jerry-fan07/windshield-ARHUD/docs/arhud-road/shots/chase-view.jpg

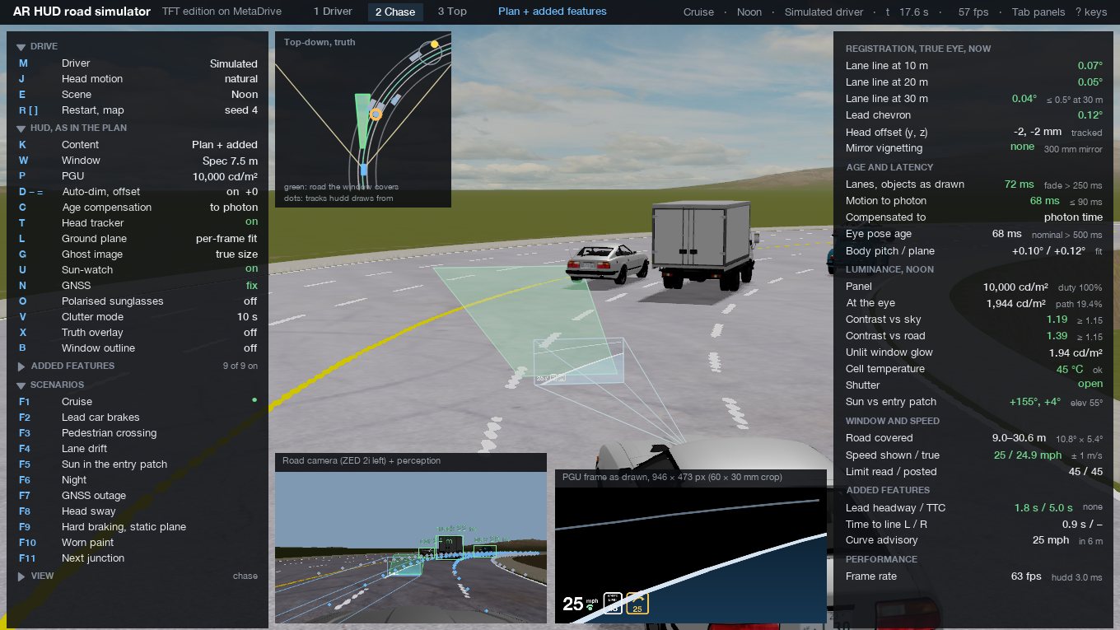
docs/arhud-road/shots/chase-view.jpg
