jerry-fan07/windshield-ARHUD/docs/arhud-road/shots/driver-hud-zoom.jpg

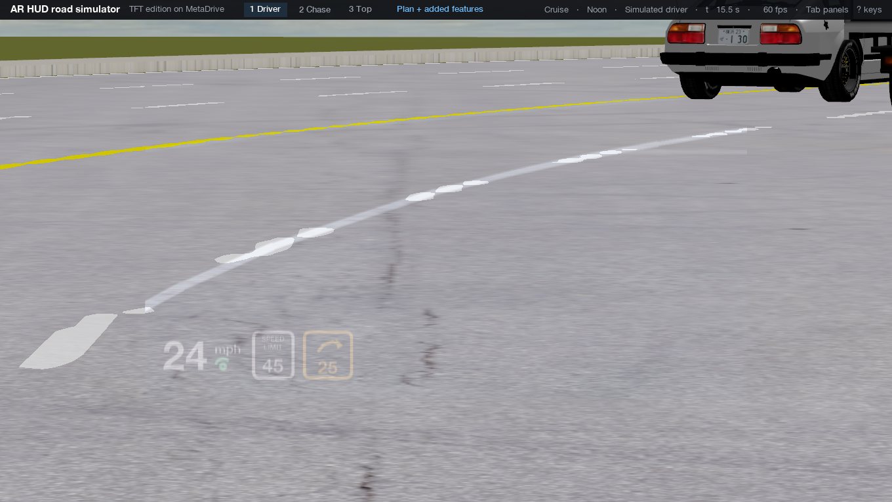
docs/arhud-road/shots/driver-hud-zoom.jpg
