jerry-fan07/windshield-ARHUD/docs/arhud-road/shots/lane-drift.jpg

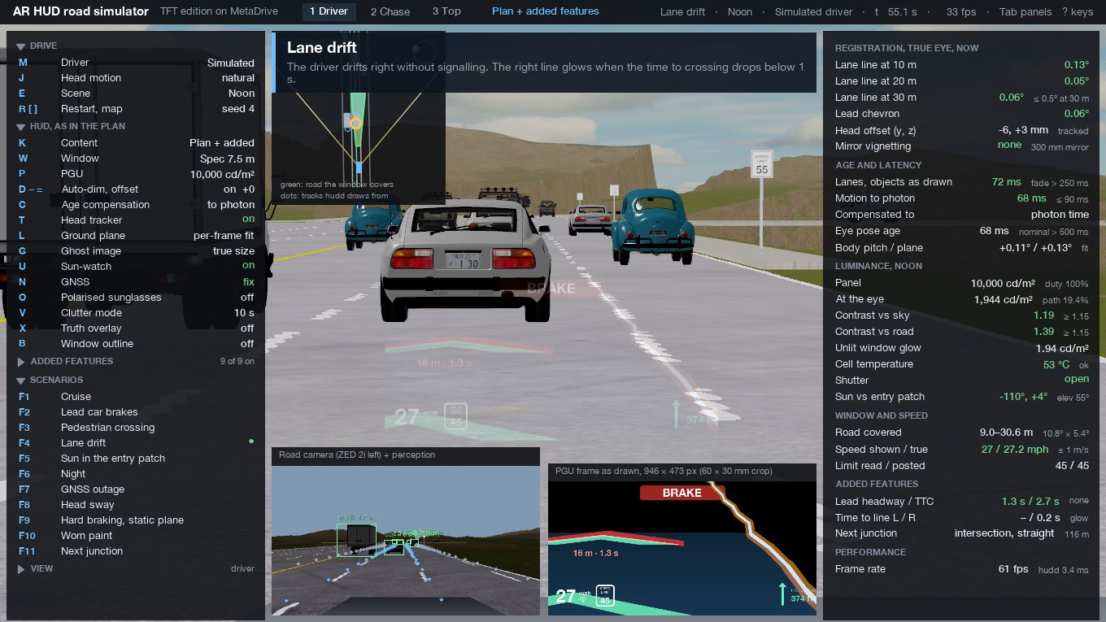
docs/arhud-road/shots/lane-drift.jpg
