jerry-fan07/windshield-ARHUD/docs/arhud-road/shots/lead-brake-fcw.jpg

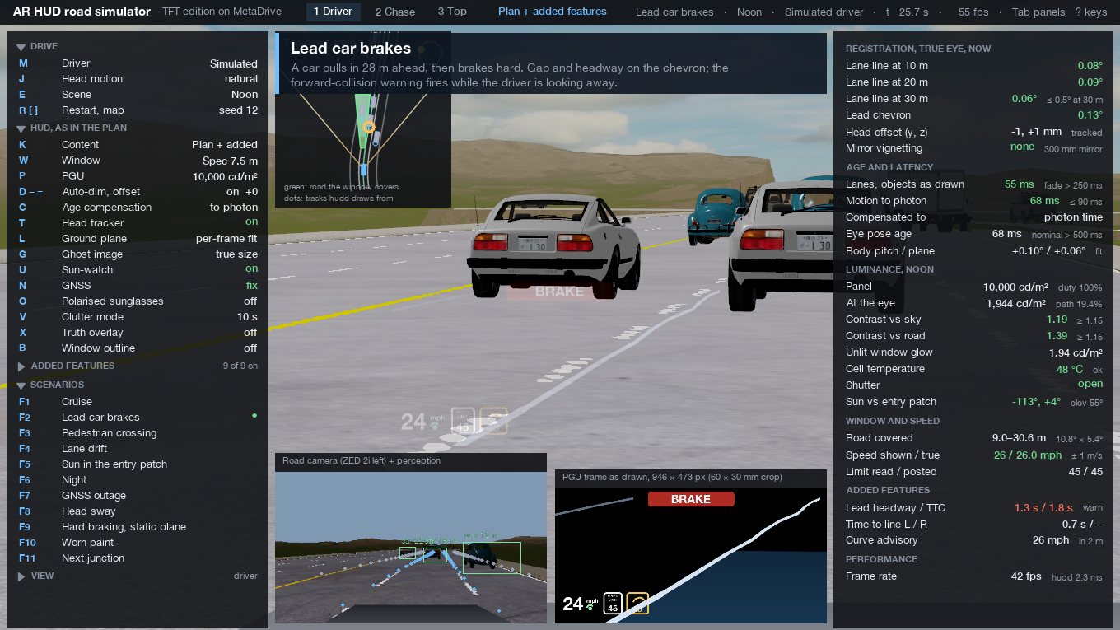
docs/arhud-road/shots/lead-brake-fcw.jpg
