jerry-fan07/windshield-ARHUD/docs/arhud-road/shots/night.jpg

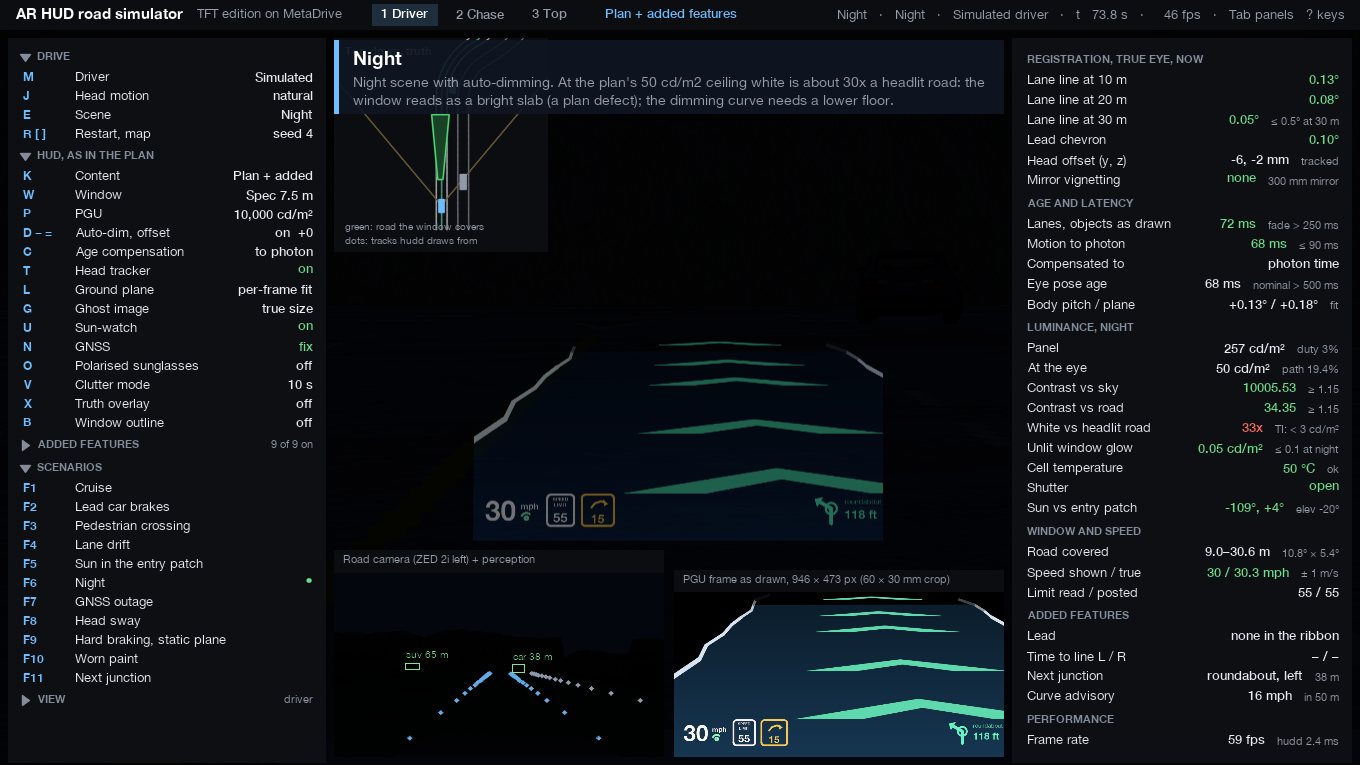
docs/arhud-road/shots/night.jpg
