jerry-fan07/windshield-ARHUD/docs/arhud-road/shots/pedestrian-crossing.jpg

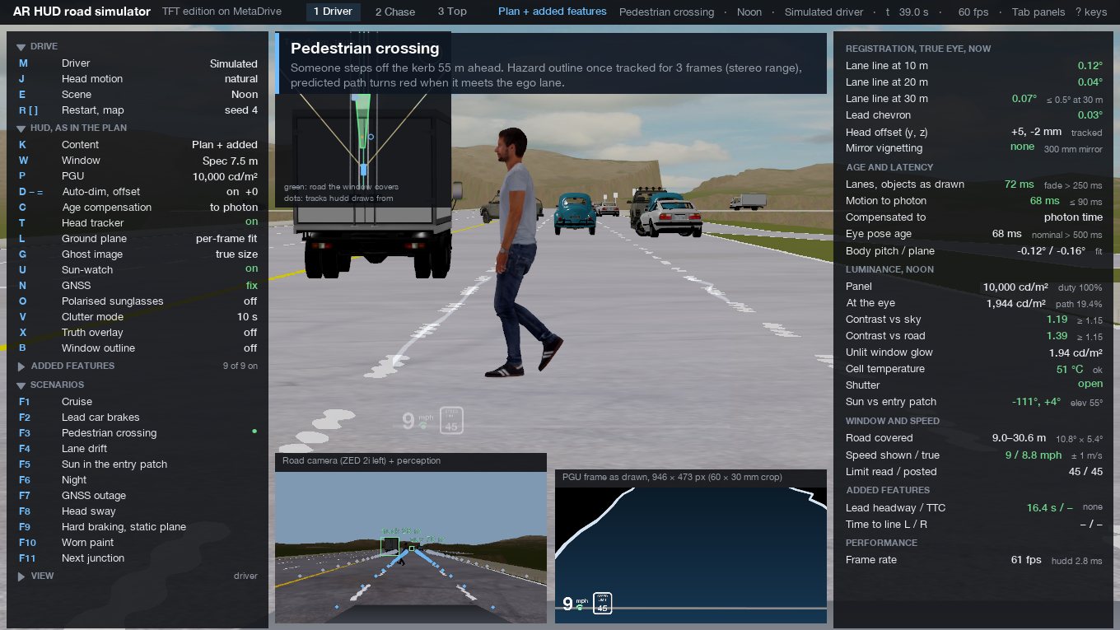
docs/arhud-road/shots/pedestrian-crossing.jpg
