jerry-fan07/windshield-ARHUD/docs/arhud-road/shots/plan-as-written.jpg

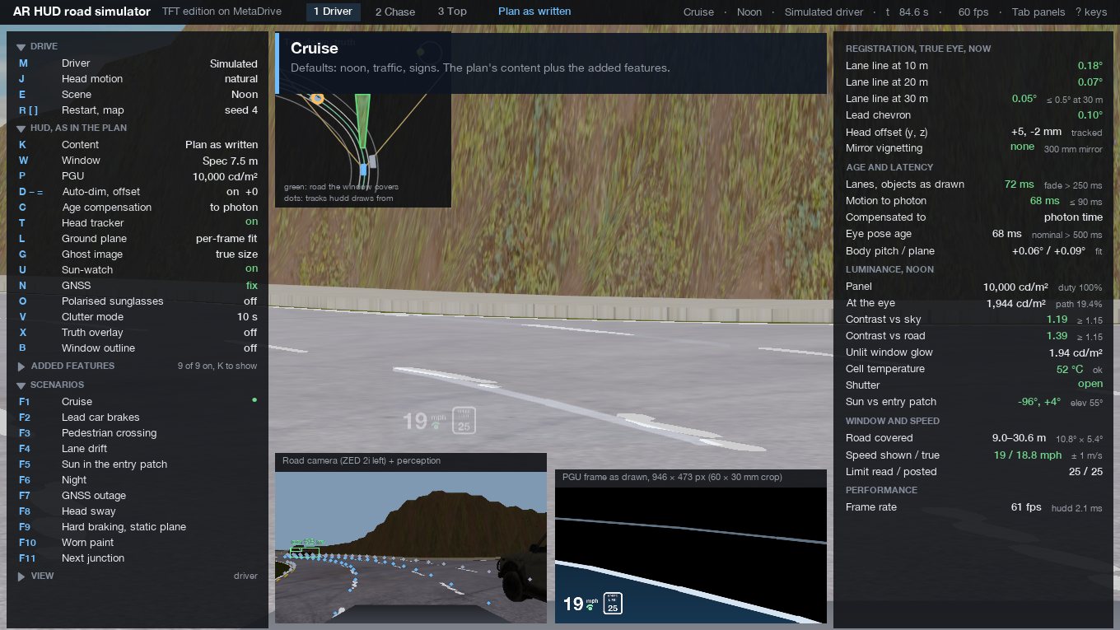
docs/arhud-road/shots/plan-as-written.jpg
