jerry-fan07/windshield-ARHUD/docs/arhud-road/shots/sun-in-patch.jpg

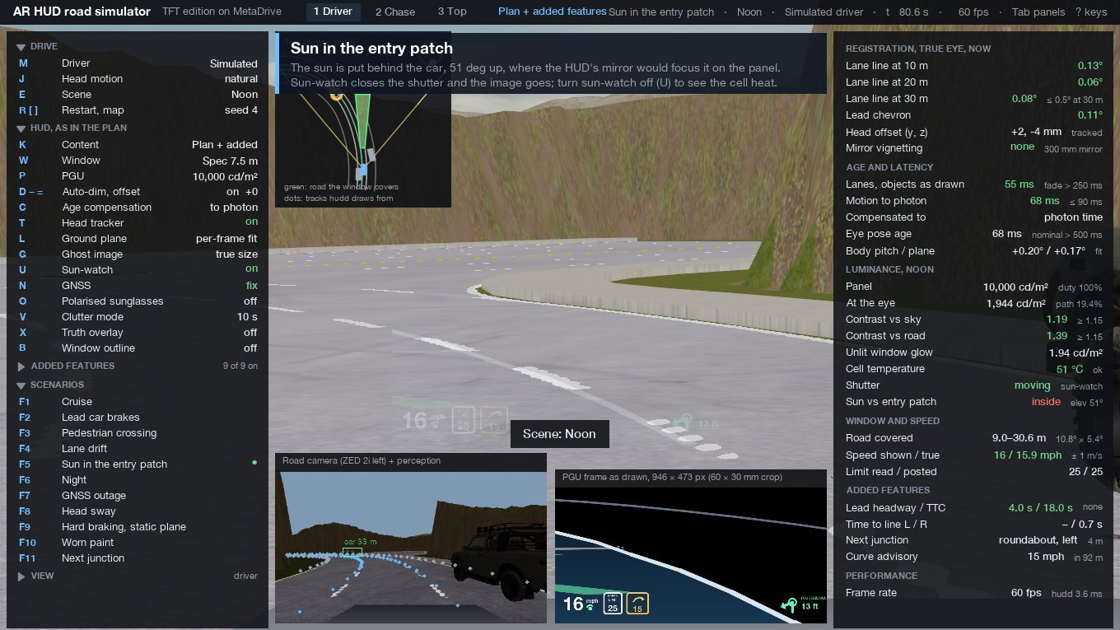
docs/arhud-road/shots/sun-in-patch.jpg
