jerry-fan07/windshield-ARHUD/docs/arhud-road/shots/turn-arrows.jpg

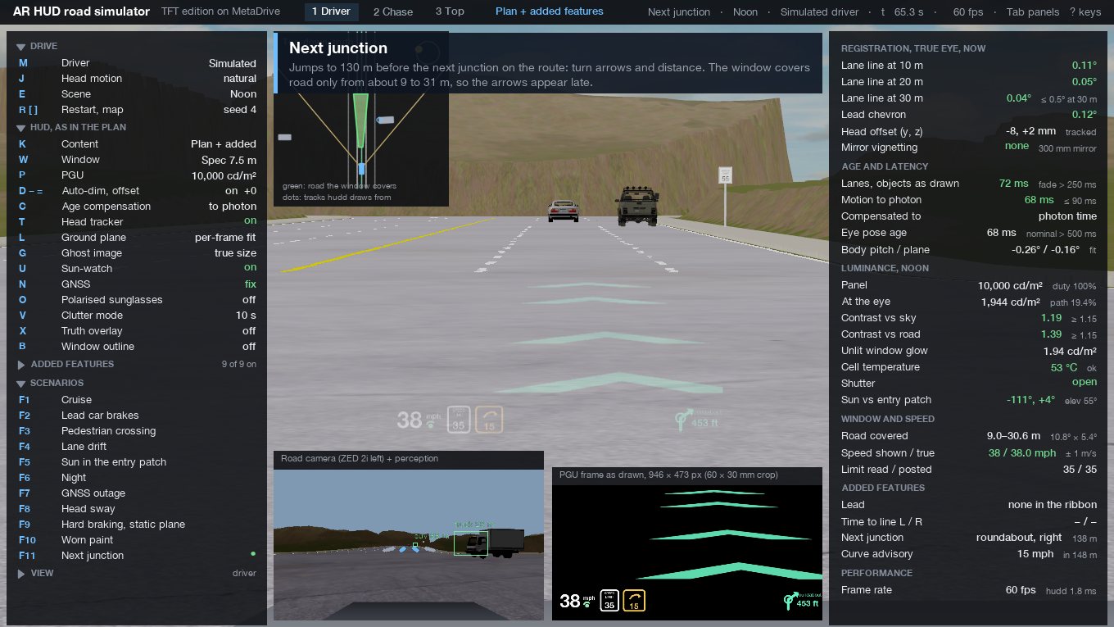
docs/arhud-road/shots/turn-arrows.jpg
