jerry-fan07/windshield-ARHUD/docs/arhud-cad/out/BOM.md

# ARHUD housing: bill of materials

Generated by `make.py` on 2026-10-22. Printed parts are ASA, matte black, each fits a 250 × 250 × 250 mm build volume in the orientation of its STL.

## Printed

| Part | Qty | Bed footprint (mm) | Supports | Mass (g, solid) |
|---|---|---|---|---|
| Body, rear left quarter (`stl/bodyRearLeft.stl`) | 1 | 229 × 247 × 185 | none | 542 |
| Body, rear right quarter (`stl/bodyRearRight.stl`) | 1 | 229 × 247 × 185 | none | 537 |
| Body, front left quarter (`stl/bodyFrontLeft.stl`) | 1 | 230 × 196 × 185 | none | 417 |
| Body, front right quarter (`stl/bodyFrontRight.stl`) | 1 | 196 × 230 × 185 | none | 413 |
| Lid, rear left (`stl/capRearLeft.stl`) | 1 | 247 × 227 × 70 | none | 311 |
| Lid, rear right (`stl/capRearRight.stl`) | 1 | 247 × 155 × 70 | none | 236 |
| Lid, front left (`stl/capFrontLeft.stl`) | 1 | 246 × 227 × 70 | none | 191 |
| Lid, front right (`stl/capFrontRight.stl`) | 1 | 246 × 155 × 70 | none | 164 |
| PGU bay (`stl/bay.stl`) | 1 | 86 × 208 × 135 | none | 331 |
| Panel carrier (`stl/carrier.stl`) | 1 | 86 × 190 × 7 | none | 70 |
| Panel mask (`stl/mask.stl`) | 1 | 85 × 140 × 2 | none | 15 |
| Fold bracket (`stl/foldBracket.stl`) | 1 | 82 × 190 × 84 | tree supports under the bottom rail | 82 |
| Mirror stand (`stl/mirrorStand.stl`) | 1 | 134 × 249 × 133 | tree supports under the triangle | 61 |
| Mirror strongback (`stl/strongback.stl`) | 1 | 150 × 240 × 14 | none | 268 |
| Mirror edge clip, left (`stl/mirrorClipL.stl`) | 1 | 44 × 38 × 16 | none | 5 |
| Mirror edge clip, right (`stl/mirrorClipR.stl`) | 1 | 44 × 38 × 16 | none | 5 |
| Light-trap vanes, left (`stl/vaneL.stl`) | 1 | 206 × 108 × 6 | none | 95 |
| Light-trap vanes, right (`stl/vaneR.stl`) | 1 | 206 × 108 × 6 | none | 95 |
| Grommet, left wall (`stl/grommetWall.stl`) | 1 | 20 × 6 × 20 | none | 1 |
| Grommet, HDMI exit (`stl/grommetHdmi.stl`) | 1 | 26 × 23 × 4 | none | 2 |
| Grommet, LED and fan leads (`stl/grommetLed.stl`) | 1 | 12 × 12 × 4 | none | 0 |
| Adjuster access plug 1 (`stl/accessPlug1.stl`) | 1 | 13 × 13 × 5 | none | 0 |
| Adjuster access plug 2 (`stl/accessPlug2.stl`) | 1 | 13 × 13 × 5 | none | 0 |
| Adjuster access plug 3 (`stl/accessPlug3.stl`) | 1 | 11 × 13 × 8 | none | 0 |
| Shutter rail, left rear (`stl/railLeftRear.stl`) | 1 | 236 × 18 × 8 | none | 32 |
| Shutter rail, left front (`stl/railLeftFront.stl`) | 1 | 177 × 18 × 8 | none | 24 |
| Shutter rail, right rear (`stl/railRightRear.stl`) | 1 | 236 × 22 × 8 | none | 41 |
| Shutter rail, right front (`stl/railRightFront.stl`) | 1 | 177 × 22 × 8 | none | 31 |
| Servo bracket (`stl/servoBracket.stl`) | 1 | 48 × 33 × 17 | none | 5 |
| Spring anchor post (`stl/springAnchor.stl`) | 1 | 8 × 8 × 6 | none | 0 |
| Glass clamps (8) (`stl/clamps.stl`) | 8 | 16 × 15 × 2 | none | 1 |
| Light-sensor pod (`stl/alsPod.stl`) | 1 | 30 × 28 × 11 | none | 4 |

## Bought and sheet parts

| Part | Qty | Specification |
|---|---|---|
| Levelling feet (4) | 4 | M5 threaded rubber levelling foot, 20 mm pad |
| Shutter leaf, rear | 1 | 0.5 mm aluminium 5052, black anodised, laser cut |
| Shutter leaf, front | 1 | 0.5 mm aluminium 5052, black anodised, laser cut |
| Dust-cover glass | 1 | 3 mm float glass, 270 x 270 mm, arrised edges, s-pass polariser laminated underneath |

## Fasteners

| Item | Qty |
|---|---|
| M3 x 10 button | 39 |
| M3 x 16 button | 4 |
| M3 x 20 button | 2 |
| M3 x 3 heat-set insert (short) | 30 |
| M3 x 5.7 heat-set insert | 53 |
| M3 x 6 button | 16 |
| M3 x 6 csk | 7 |
| M3 x 8 button | 29 |
| M4 x 30 socket | 3 |
| M4 x 8.1 heat-set insert | 3 |
| M5 x 9.5 heat-set insert | 4 |
| RTV silicone bonding pad, 25 mm x 1 mm | 3 |
| compression spring 9 x 15 mm, music wire | 3 |
