jerry-fan07/windshield-ARHUD/docs/arhud-blender/export/mirror_freeform_curved.stl

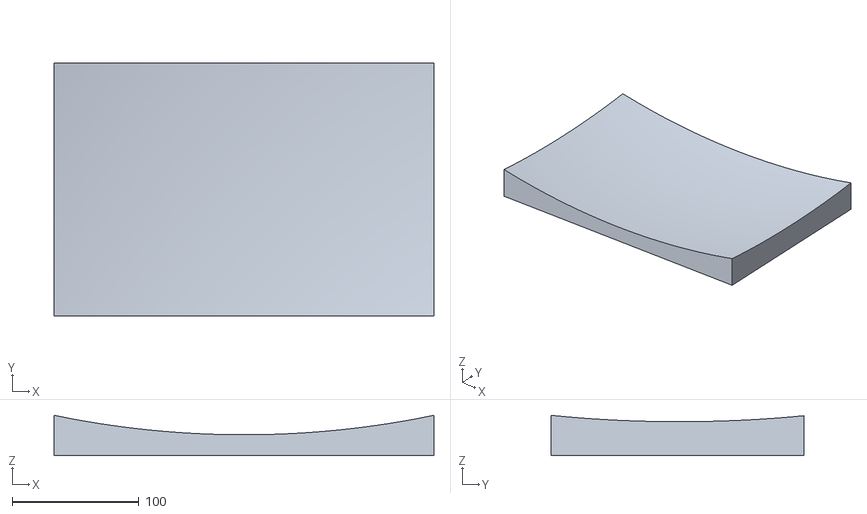
[picture p19: CAD file, 2026-10-26]
docs/arhud-blender/export/mirror_freeform_curved.stl
300.0 x 200.0 x 32.0
