jerry-fan07/windshield-ARHUD/docs/arhud-cad/out/shutter-leaves.dxf

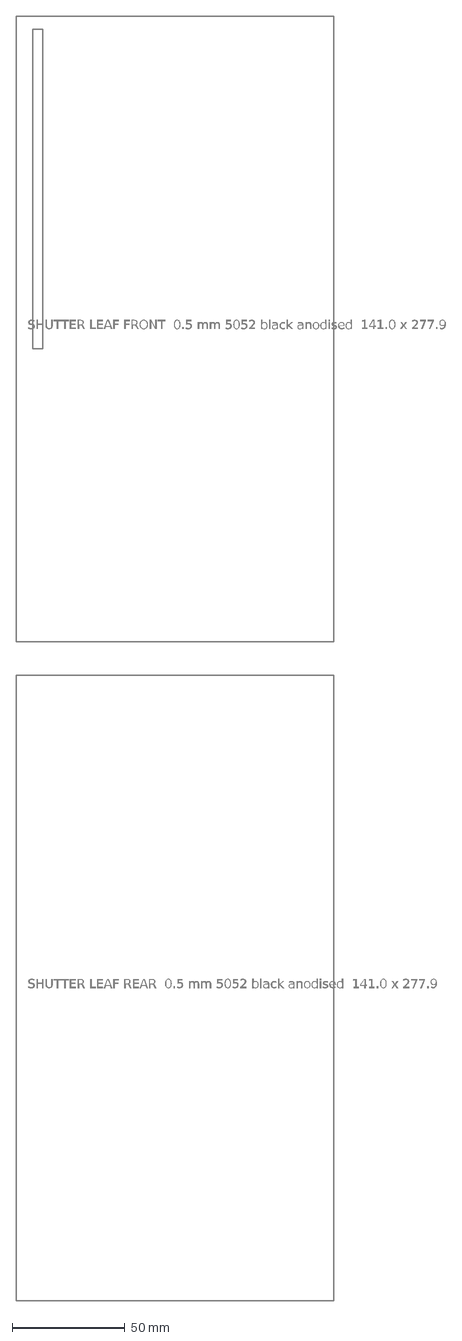
[picture p20: CAD file, 2026-10-26]
docs/arhud-cad/out/shutter-leaves.dxf
SHUTTER LEAF REAR 0.5 mm 5052 black anodised 141.0 x 277.9
SHUTTER LEAF FRONT 0.5 mm 5052 black anodised 141.0 x 277.9
