jerry-fan07/windshield-ARHUD/docs/arhud-cad/out/stl/vaneR.stl

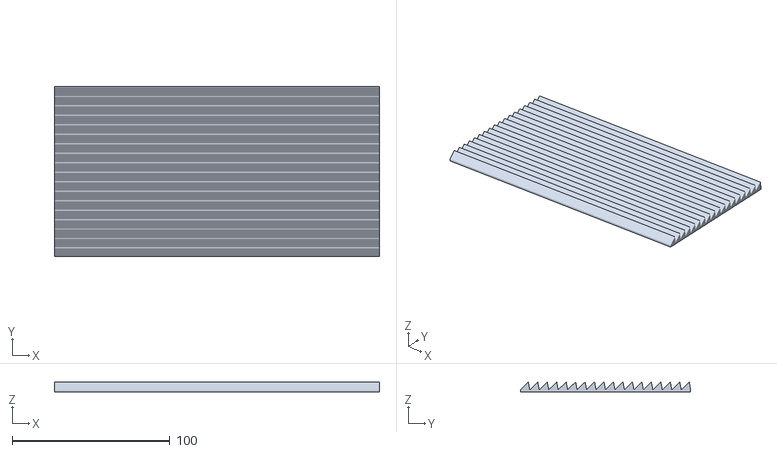
[picture p21: CAD file, 2026-10-26]
docs/arhud-cad/out/stl/vaneR.stl
206.0 x 108.0 x 6.50
