jerry-fan07/windshield-ARHUD/docs/arhud-blender/export/mirror_freeform.stl

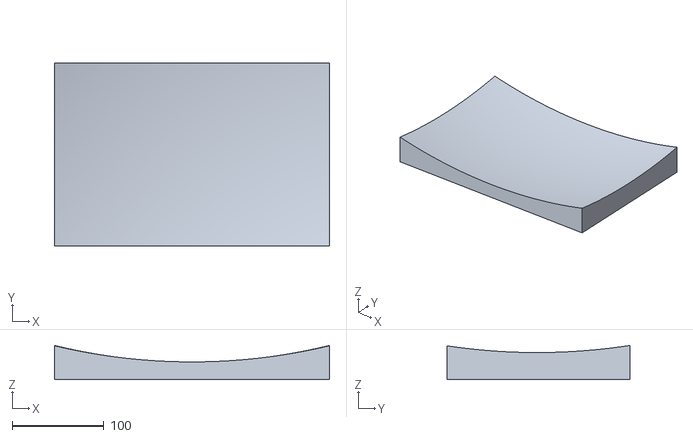
[picture p22: CAD file, 2026-10-26]
docs/arhud-blender/export/mirror_freeform.stl
300.0 x 200.0 x 37.3
