jerry-fan07/windshield-ARHUD/docs/arhud-cad/out/arhud-housing.step

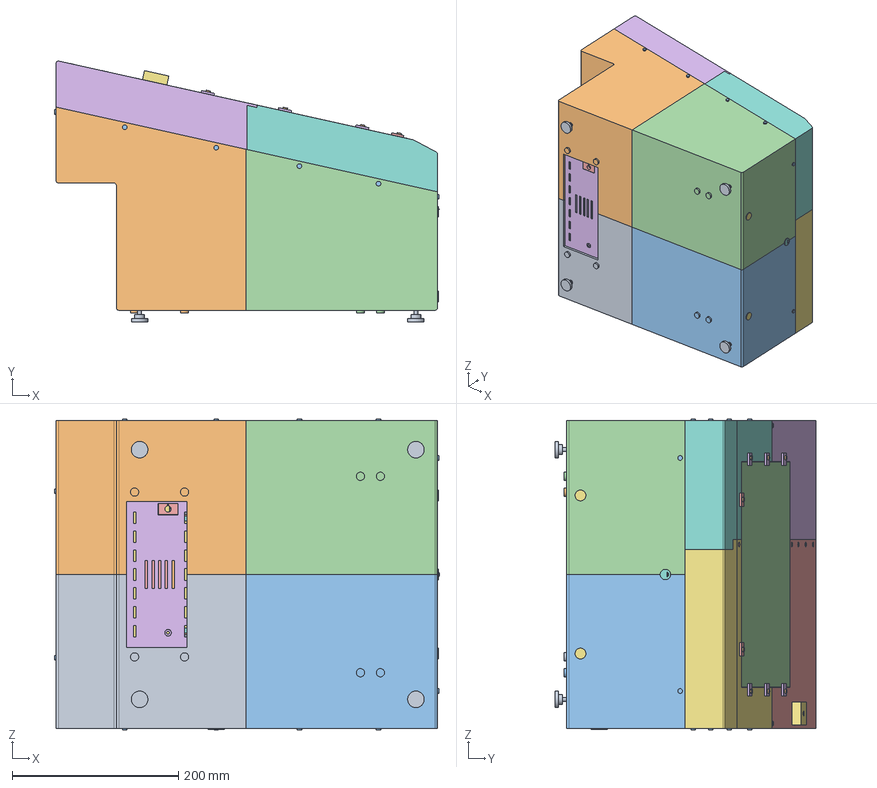
[picture p23: CAD file, 2026-10-26]
docs/arhud-cad/out/arhud-housing.step
462.6 x 313.5 x 373.4 mm
bodyRearLeft
bodyRearRight
bodyFrontLeft
bodyFrontRight
capRearLeft
capRearRight
capFrontLeft
capFrontRight
hwShell0
hwShell1
hwShell2
hwShell3
hwShell4
hwShell5
hwShell6
hwShell7
hwShell8
hwShell9
hwShell10
bay
carrier
mask
foldBracket
hwBay0
hwBay1
hwBay2
hwBay3
hwPanel0
hwPanel1
hwPanel2
hwPanel3
mirrorStand
strongback
mirrorClipL
mirrorClipR
hwMirrorA0
hwMirrorA1
hwMirrorB0
hwMirrorB1
hwMirrorB2
hwMirrorB3
vaneL
vaneR
grommetWall
grommetHdmi
grommetLed
accessPlug1
accessPlug2
accessPlug3
feet
hwFeet0
railLeftRear
railLeftFront
railRightRear
railRightFront
servoBracket
springAnchor
hwShutter0
hwShutter1
hwShutter2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
