jerry-fan07/windshield-ARHUD/docs/arhud-cad/out/stl/accessPlug1.stl

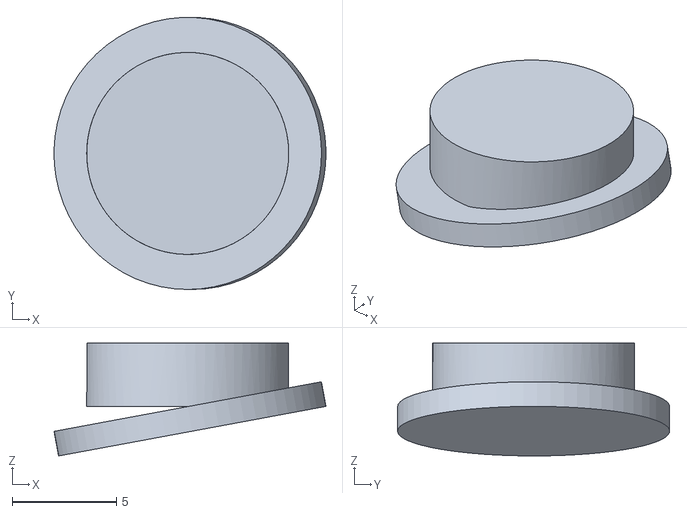
[picture p24: CAD file, 2026-10-26]
docs/arhud-cad/out/stl/accessPlug1.stl
13.1 x 13.1 x 5.42
