jerry-fan07/windshield-ARHUD/docs/arhud-cad/out/stl/foldBracket.stl

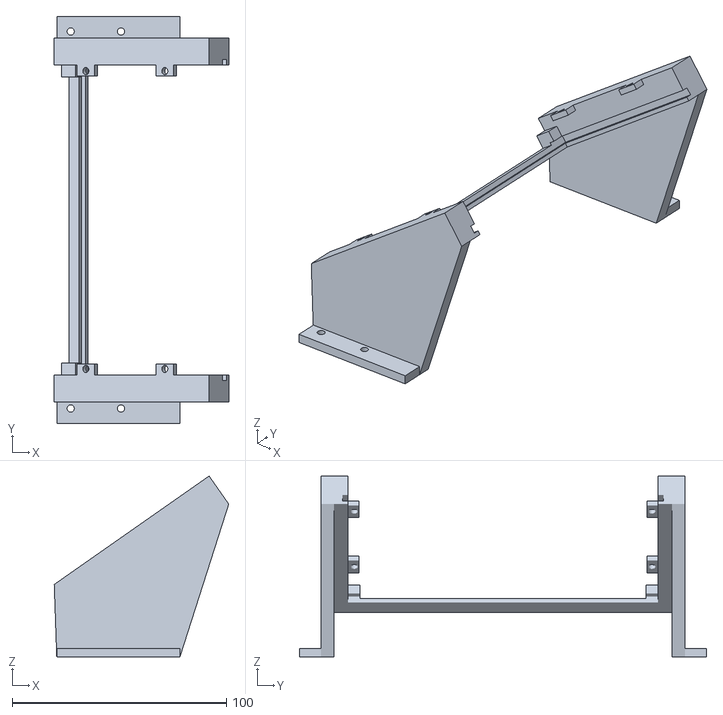
[picture p25: CAD file, 2026-10-26]
docs/arhud-cad/out/stl/foldBracket.stl
81.5 x 190.0 x 84.5
