jerry-fan07/windshield-ARHUD/docs/arhud-cad/out/stl/bodyRearRight.stl

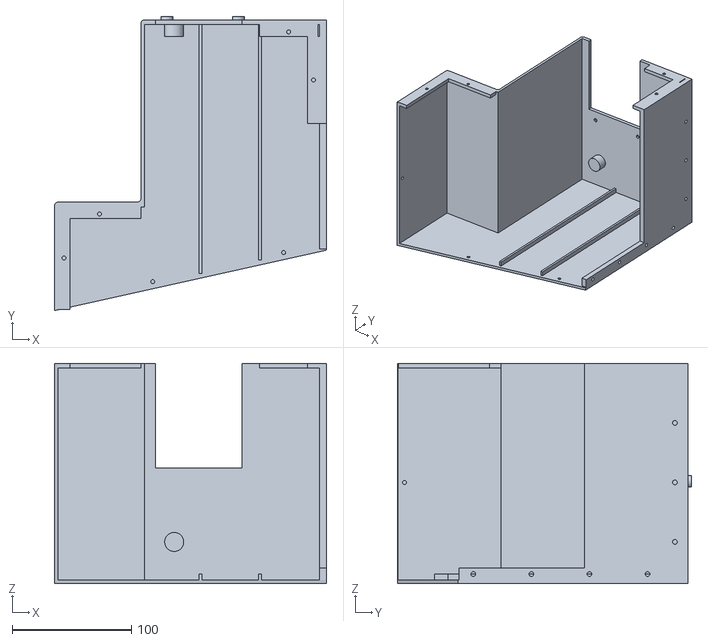
[picture p26: CAD file, 2026-10-26]
docs/arhud-cad/out/stl/bodyRearRight.stl
228.6 x 247.2 x 185.0
