jerry-fan07/windshield-ARHUD/docs/arhud-cad/out/stl/bay.stl

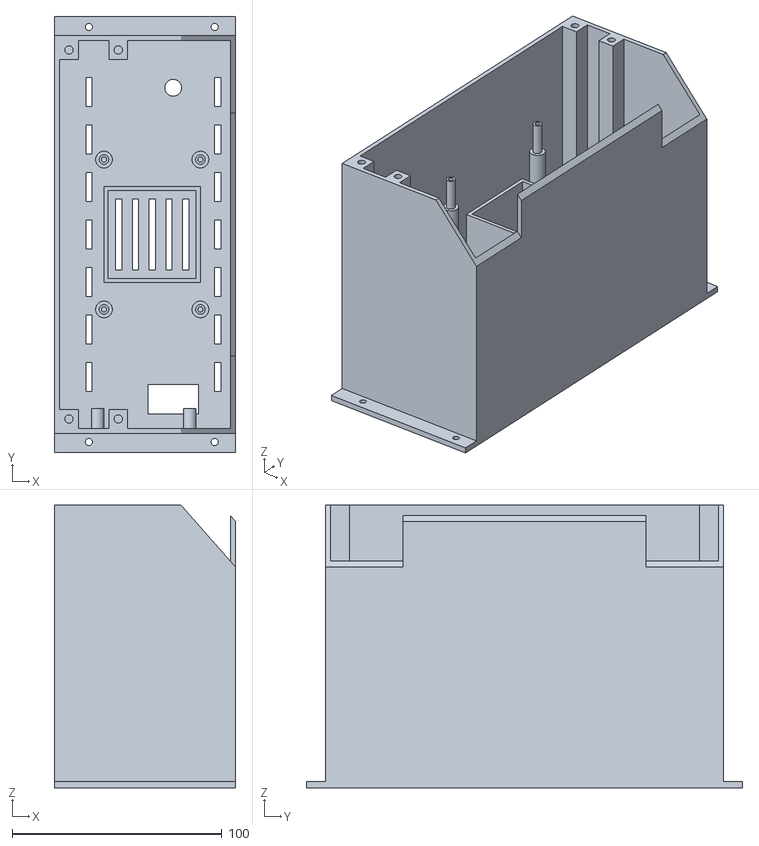
[picture p27: CAD file, 2026-10-26]
docs/arhud-cad/out/stl/bay.stl
86.5 x 208.0 x 135.0
