jerry-fan07/windshield-ARHUD/docs/arhud-cad/out/stl/capRearRight.stl

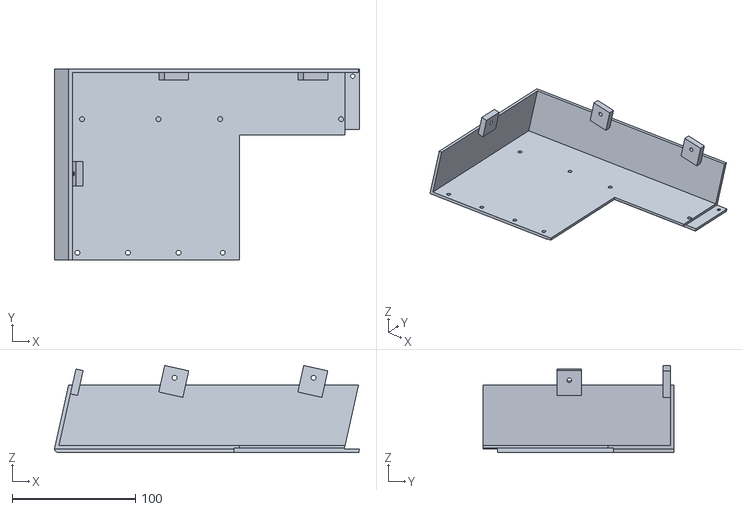
[picture p28: CAD file, 2026-10-26]
docs/arhud-cad/out/stl/capRearRight.stl
247.1 x 155.0 x 70.5
