jerry-fan07/windshield-ARHUD/docs/arhud-cad/out/stl/strongback.stl

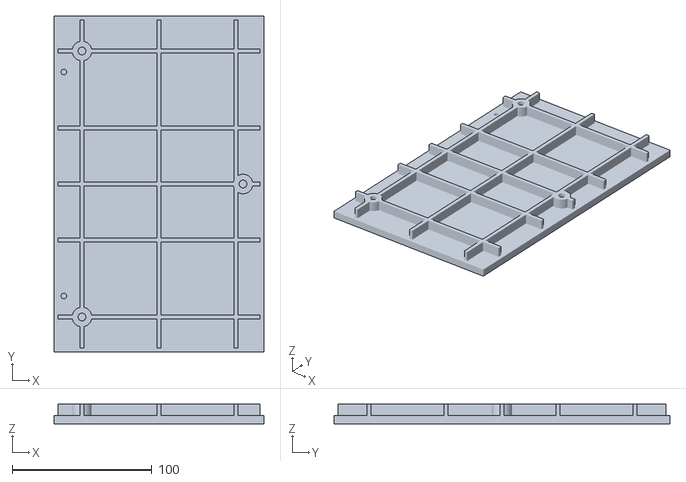
[picture p29: CAD file, 2026-10-26]
docs/arhud-cad/out/stl/strongback.stl
150.0 x 240.0 x 14.0
