jerry-fan07/windshield-ARHUD/docs/arhud-cad/out/stl/mirrorClipL.stl

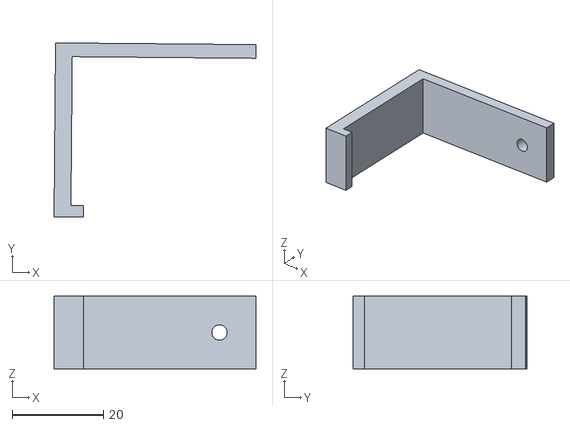
[picture p30: CAD file, 2026-10-26]
docs/arhud-cad/out/stl/mirrorClipL.stl
44.3 x 38.2 x 16.0
