jerry-fan07/windshield-ARHUD/docs/arhud-cad/out/stl/grommetWall.stl

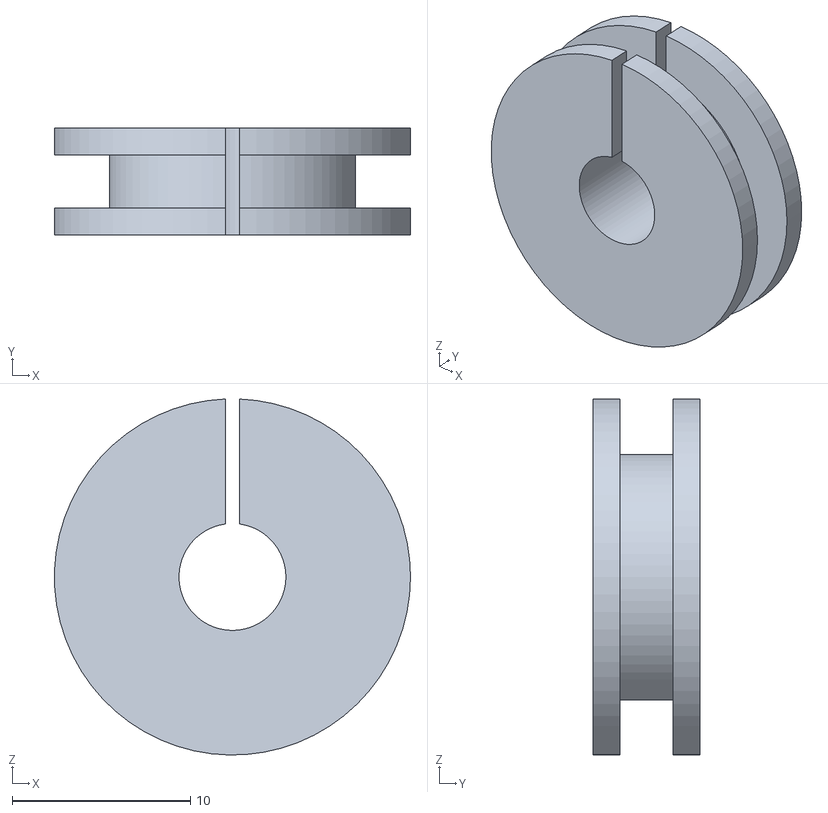
[picture p31: CAD file, 2026-10-26]
docs/arhud-cad/out/stl/grommetWall.stl
20.0 x 6.00 x 20.0
