jerry-fan07/windshield-ARHUD/docs/arhud-cad/out/stl/alsPod.stl

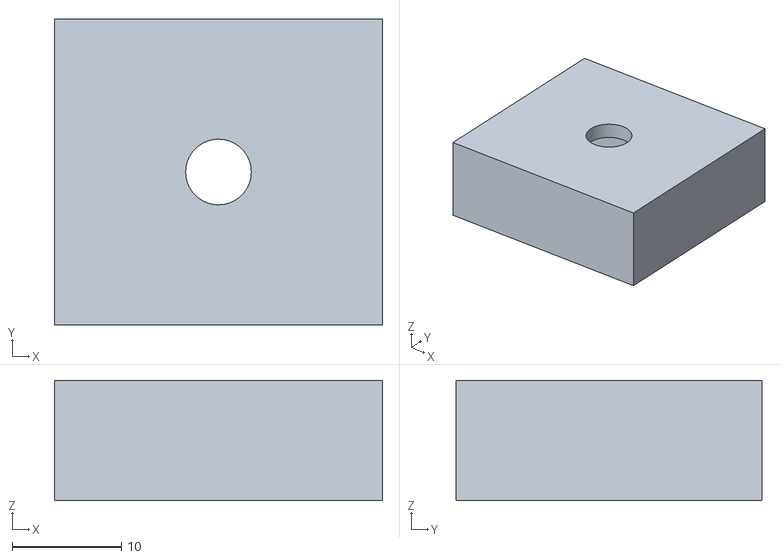
[picture p32: CAD file, 2026-10-26]
docs/arhud-cad/out/stl/alsPod.stl
30.0 x 28.0 x 11.0
