jerry-fan07/windshield-ARHUD/docs/arhud-cad/out/stl/bodyFrontLeft.stl

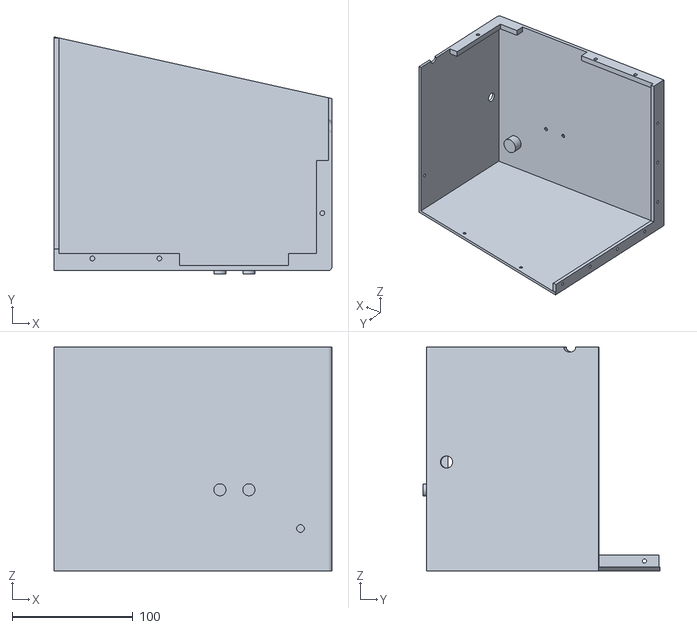
[picture p33: CAD file, 2026-10-26]
docs/arhud-cad/out/stl/bodyFrontLeft.stl
230.1 x 196.4 x 185.0
