jerry-fan07/windshield-ARHUD/docs/arhud-cad/out/stl/servoBracket.stl

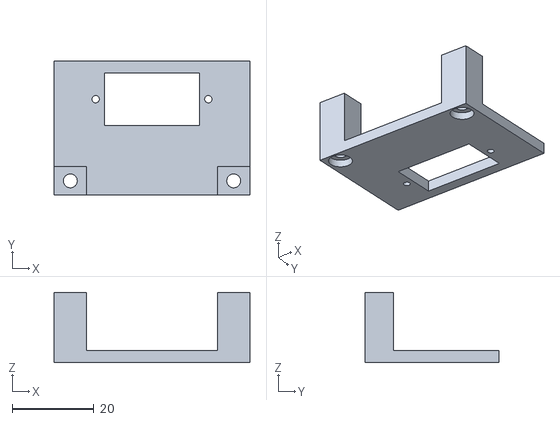
[picture p34: CAD file, 2026-10-26]
docs/arhud-cad/out/stl/servoBracket.stl
48.0 x 32.9 x 17.2
