jerry-fan07/windshield-ARHUD/docs/arhud-cad/out/stl/grommetLed.stl

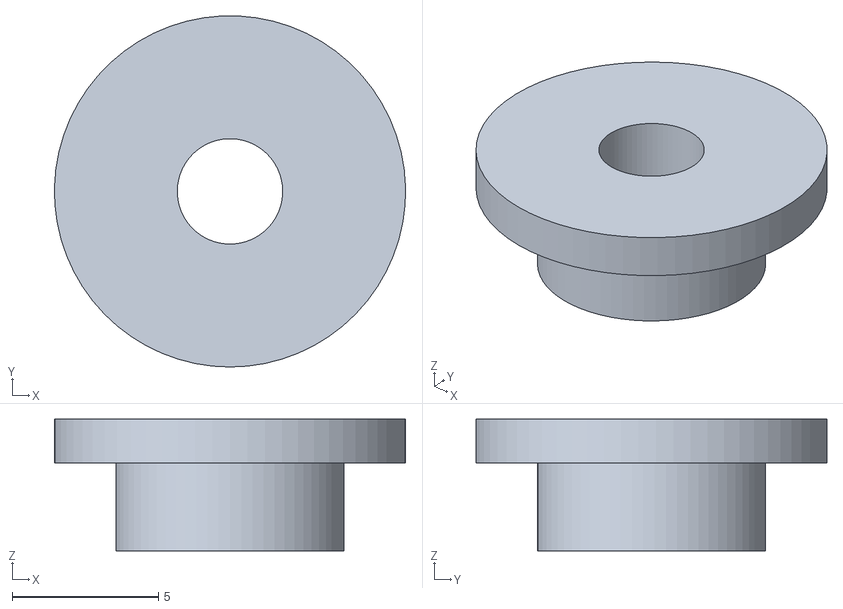
[picture p35: CAD file, 2026-10-26]
docs/arhud-cad/out/stl/grommetLed.stl
12.0 x 12.0 x 4.50
