jerry-fan07/windshield-ARHUD/docs/arhud-cad/out/stl/mask.stl

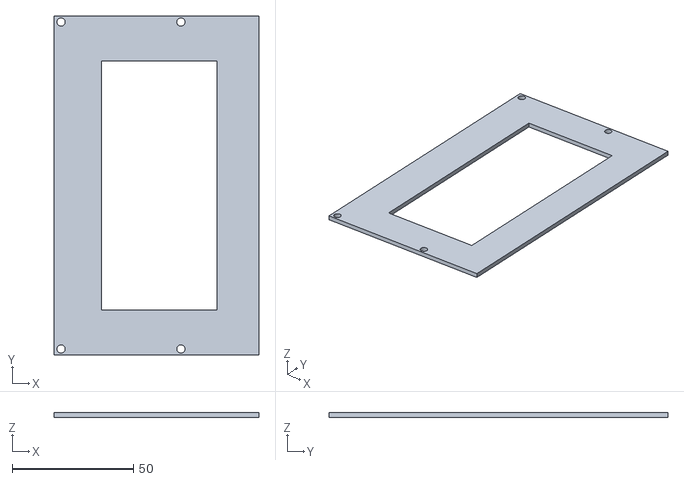
[picture p36: CAD file, 2026-10-26]
docs/arhud-cad/out/stl/mask.stl
84.6 x 140.0 x 2.00
