jerry-fan07/windshield-ARHUD/docs/arhud-cad/out/stl/grommetHdmi.stl

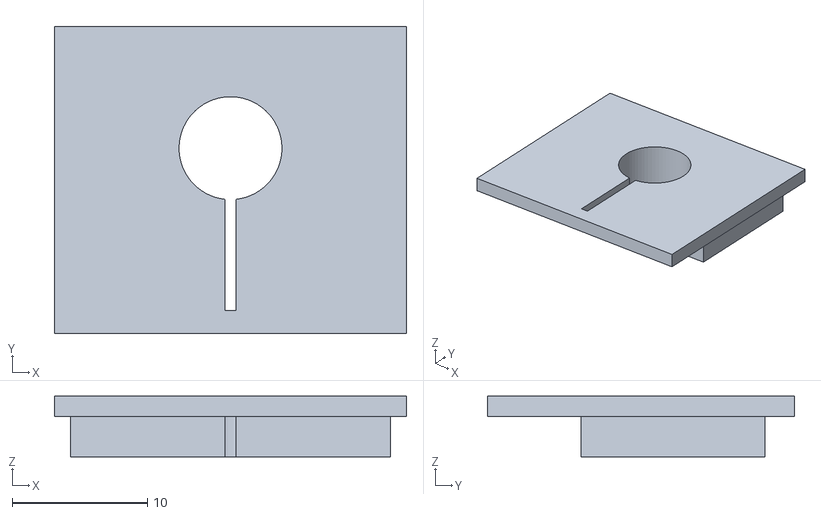
[picture p37: CAD file, 2026-10-26]
docs/arhud-cad/out/stl/grommetHdmi.stl
26.0 x 22.7 x 4.50
