jerry-fan07/windshield-ARHUD/docs/arhud-cad/out/stl/capRearLeft.stl

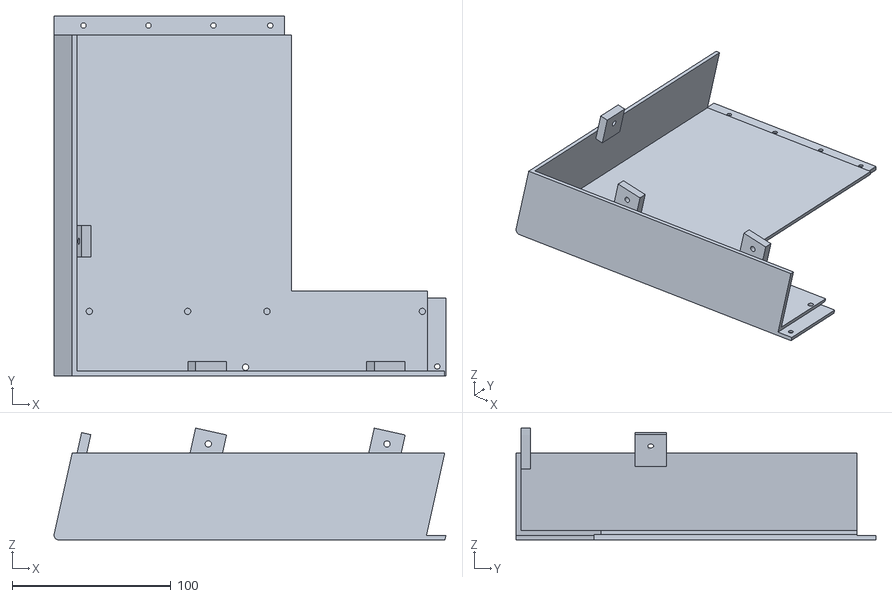
[picture p38: CAD file, 2026-10-26]
docs/arhud-cad/out/stl/capRearLeft.stl
247.1 x 227.0 x 70.5
