jerry-fan07/windshield-ARHUD/docs/arhud-cad/out/stl/railRightRear.stl

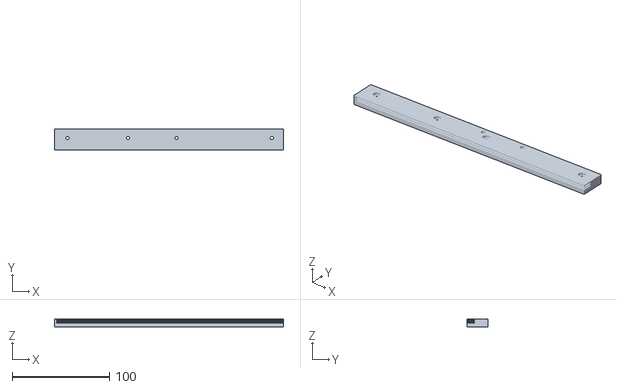
[picture p39: CAD file, 2026-10-26]
docs/arhud-cad/out/stl/railRightRear.stl
235.5 x 22.0 x 8.50
