jerry-fan07/windshield-ARHUD/docs/arhud-cad/out/stl/mirrorStand.stl

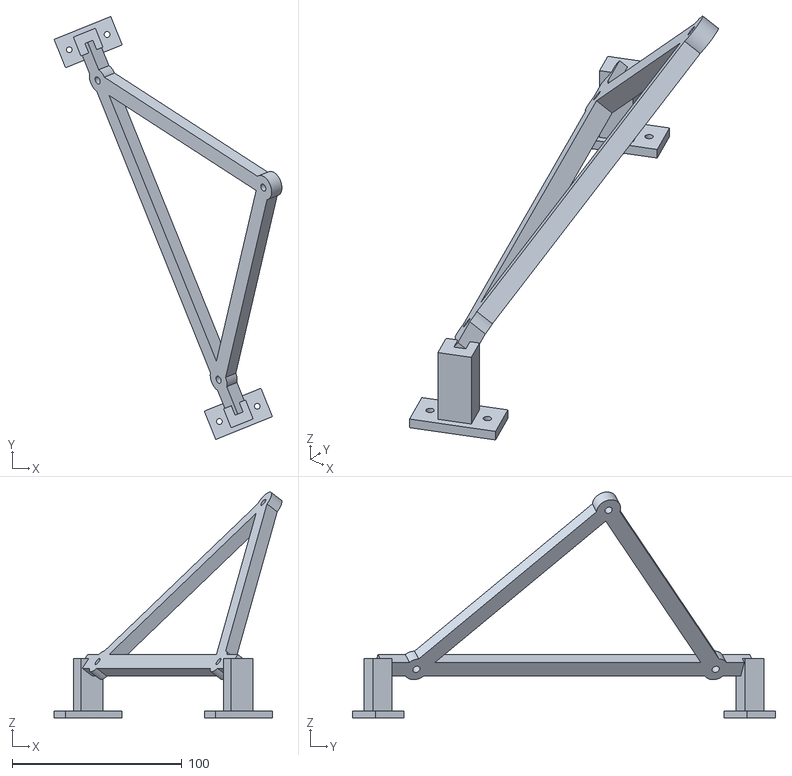
[picture p40: CAD file, 2026-10-26]
docs/arhud-cad/out/stl/mirrorStand.stl
134.1 x 249.0 x 133.0
