jerry-fan07/windshield-ARHUD/docs/arhud-cad/out/stl/railLeftRear.stl

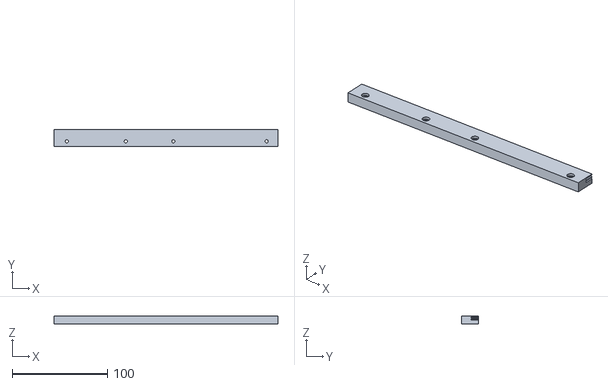
[picture p41: CAD file, 2026-10-26]
docs/arhud-cad/out/stl/railLeftRear.stl
235.5 x 18.0 x 8.50
