jerry-fan07/windshield-ARHUD/docs/arhud-cad/out/stl/accessPlug3.stl

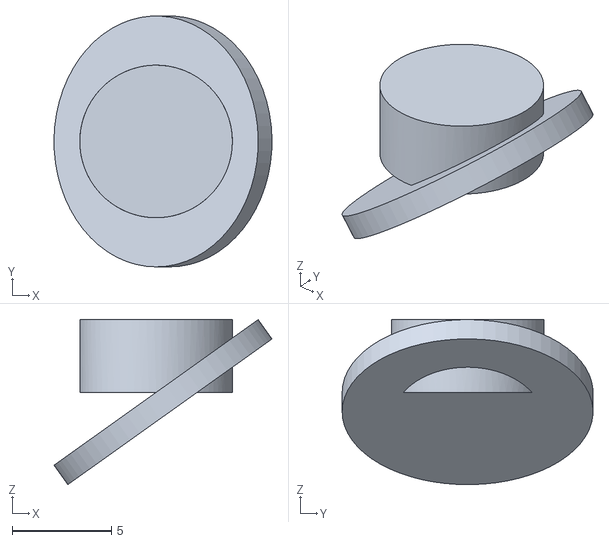
[picture p42: CAD file, 2026-10-26]
docs/arhud-cad/out/stl/accessPlug3.stl
11.0 x 12.7 x 8.34
