jerry-fan07/windshield-ARHUD/docs/arhud-cad/out/stl/capFrontRight.stl

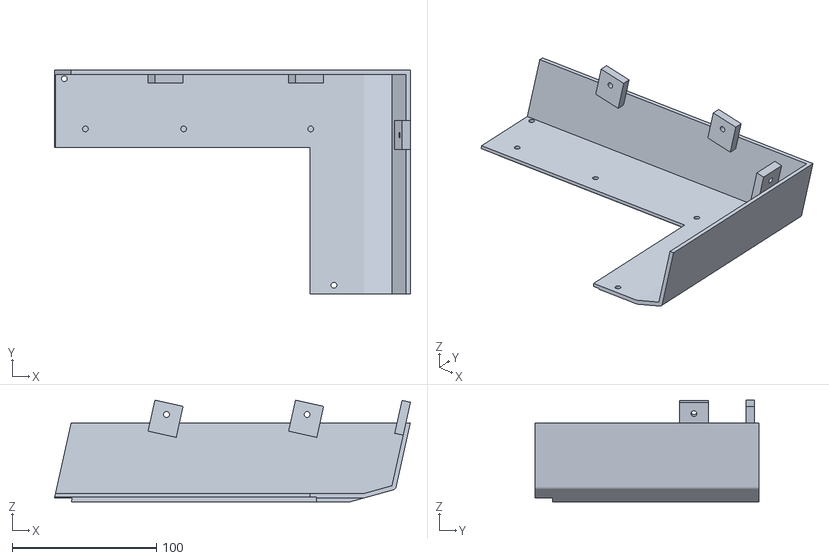
[picture p43: CAD file, 2026-10-26]
docs/arhud-cad/out/stl/capFrontRight.stl
246.5 x 155.0 x 70.5
