jerry-fan07/windshield-ARHUD/docs/arhud-cad/out/stl/railRightFront.stl

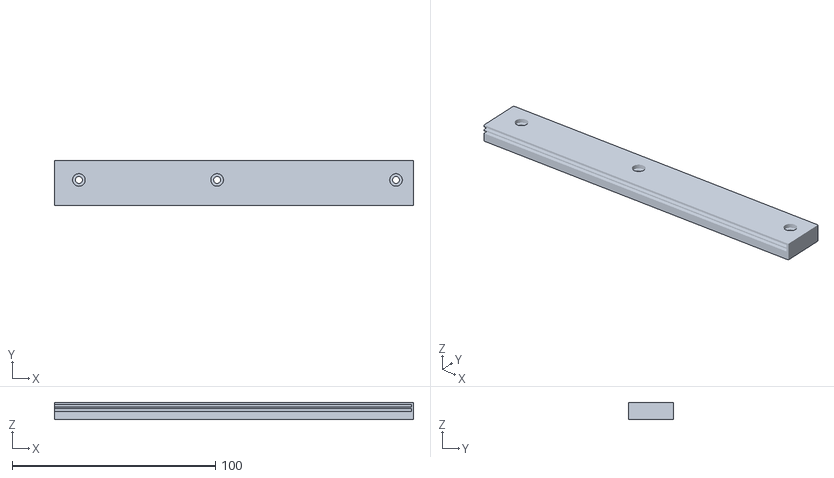
[picture p44: CAD file, 2026-10-26]
docs/arhud-cad/out/stl/railRightFront.stl
176.6 x 22.0 x 8.50
