jerry-fan07/windshield-ARHUD/docs/arhud-cad/out/stl/carrier.stl

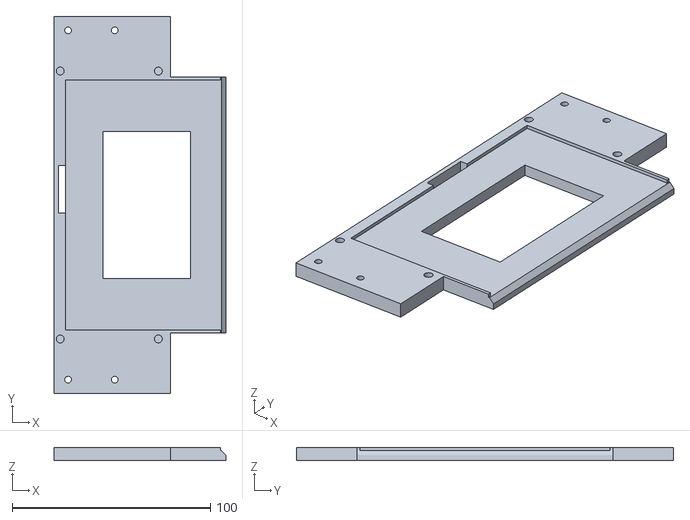
[picture p45: CAD file, 2026-10-26]
docs/arhud-cad/out/stl/carrier.stl
86.5 x 190.0 x 6.80
