jerry-fan07/windshield-ARHUD/docs/arhud-cad/out/stl/springAnchor.stl

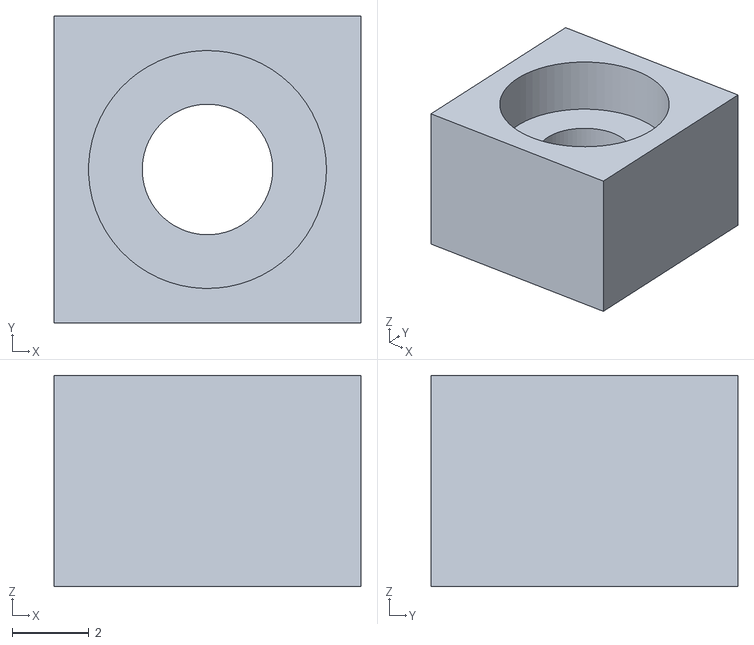
[picture p46: CAD file, 2026-10-26]
docs/arhud-cad/out/stl/springAnchor.stl
8.00 x 8.00 x 5.50
