jerry-fan07/windshield-ARHUD/docs/arhud-cad/out/stl/capFrontLeft.stl

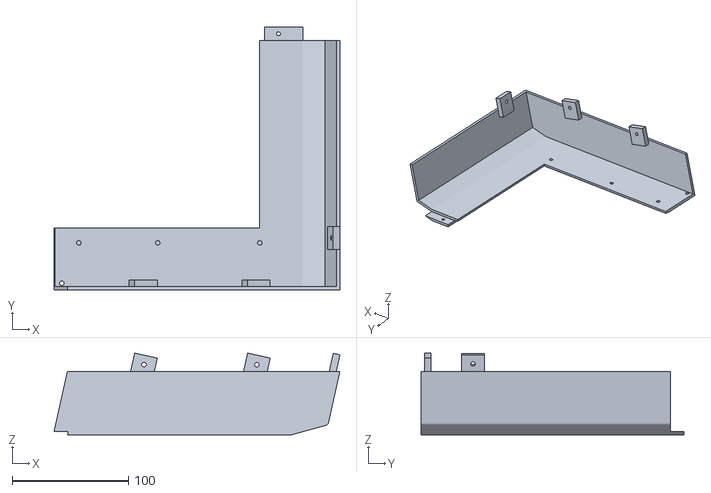
[picture p47: CAD file, 2026-10-26]
docs/arhud-cad/out/stl/capFrontLeft.stl
246.5 x 227.0 x 70.5
