jerry-fan07/windshield-ARHUD/docs/arhud-cad/out/stl/railLeftFront.stl

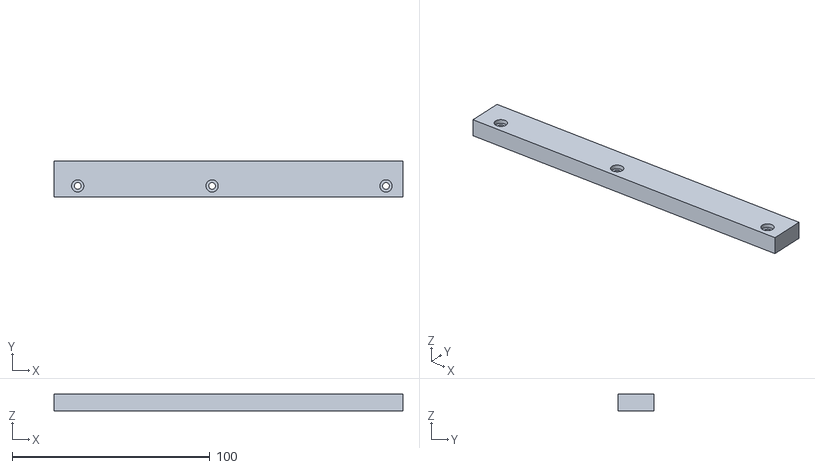
[picture p48: CAD file, 2026-10-26]
docs/arhud-cad/out/stl/railLeftFront.stl
176.6 x 18.0 x 8.50
