jerry-fan07/windshield-ARHUD/docs/arhud-cad/out/stl/clamps.stl

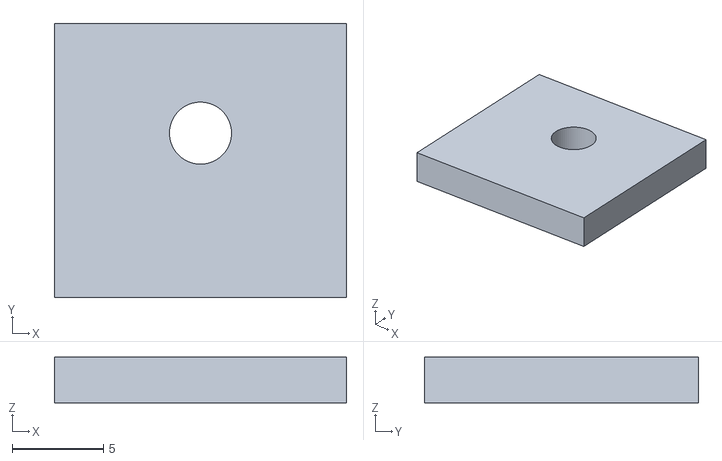
[picture p49: CAD file, 2026-10-26]
docs/arhud-cad/out/stl/clamps.stl
16.0 x 15.0 x 2.50
