jerry-fan07/windshield-ARHUD/(list of files, cad)

Other CAD files:
docs/arhud-cad/out/stl/vaneL.stl
docs/arhud-cad/out/stl/bodyRearLeft.stl
docs/arhud-cad/out/stl/bodyFrontRight.stl
docs/arhud-xray/arhud-xray.blend
